Robotvasya/SensorViolin/images/preview/p001.jpg

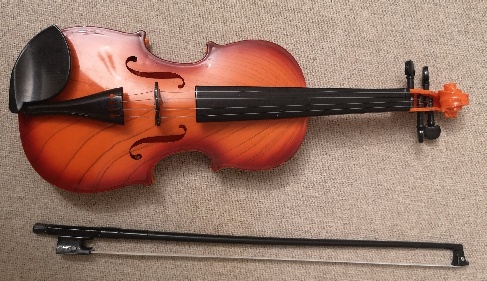
images/preview/p001.jpg
