Robotvasya/SensorViolin/images/TTP223.jpg

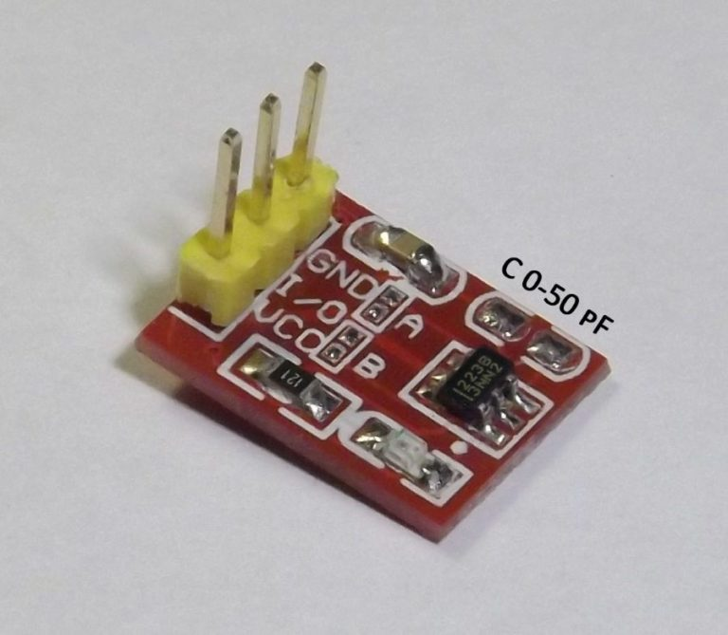
images/TTP223.jpg
