Robotvasya/SensorViolin/(commit log)

2020-01-16 circuit image uploaded
2020-05-18 circuit fix
